yfzzzyyls/ECE9433-SoC-Design-Project/docs/course_ece9433_tutorial_dc_tsmc16.pdf

Tutorial | ECE 9433: System-On-Chip Design

# Tutorial: Design Compiler NXT

## 1 Introduction

This tutorial provides a step-by-step guide to using Synopsys Design compiler, one of the most widely used tools for logic synthesis in digital design. Synthesis is a crucial phase in digital design, transforming a high-level description of a circuit, typically written in HDL like Verilog, SystemVerilog or VHDL, into a gate-level netlist. A simple design is uploaded to brightspace, please download and import the design folder to fastX3.

Main steps in Synthesis Flow:

- Specify Libraries
- Read RTL
- Applying Timing Constraints
- Synthesize the Design
- Generate Reports
- Save the Results

## 2 Specify Libraries

1. Edit your ˜/tcshrc synopsys local file by changing the value of SYN HOME to:

/eda/synopsys/syn/W-2024.09-SP5-5

Then add the following line at the bottom of the file:

set path=($SYN˙HOME/bin $path)

2. Unzip the folder using the command: unzip lab1.zip. Change the directory to lab1. The setup.tcl file sources the rm setup/dc setup.tcl file which in turn sources the rm setup/common setup.tcl file.
3. Invoke the DC NXT in topographical mode using the command: dcnxt˙shell -topo -gui
4. Execute the command from the same terminal you launched the tool or you can run these command from the input area at the bottom of the GUI: source setup.tcl

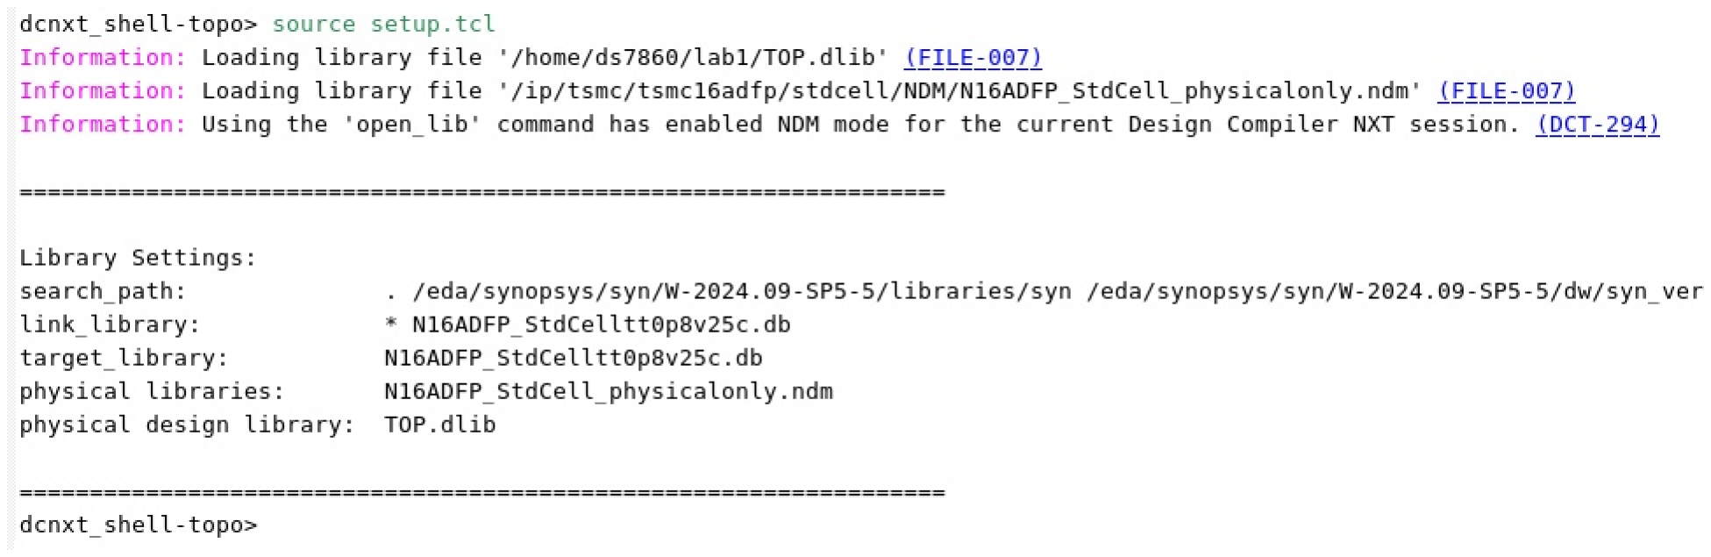
[picture p3: figure]

Fall 2025

## 3 Read RTL

1. Depending on the type of file, specify the format as shown below (enter only one of the following):
a. analyze -f verilog TOP.v
b. analyze -f vhdl TOP.vhd
2. After reading the rtl file, elaborate the design by specifying the TOP module name: elaborate TOP
3. Now you should be able to see the modules in the Logical Hierarchy pane at the upper-left of the GUI, there is a T icon called TOP, which is the top-level, and there are icons for the lower level hierarchical (H) instances as shown below:
4. Use the following commands to list the libraries and designs:
a. list˙libs
b. list˙designs

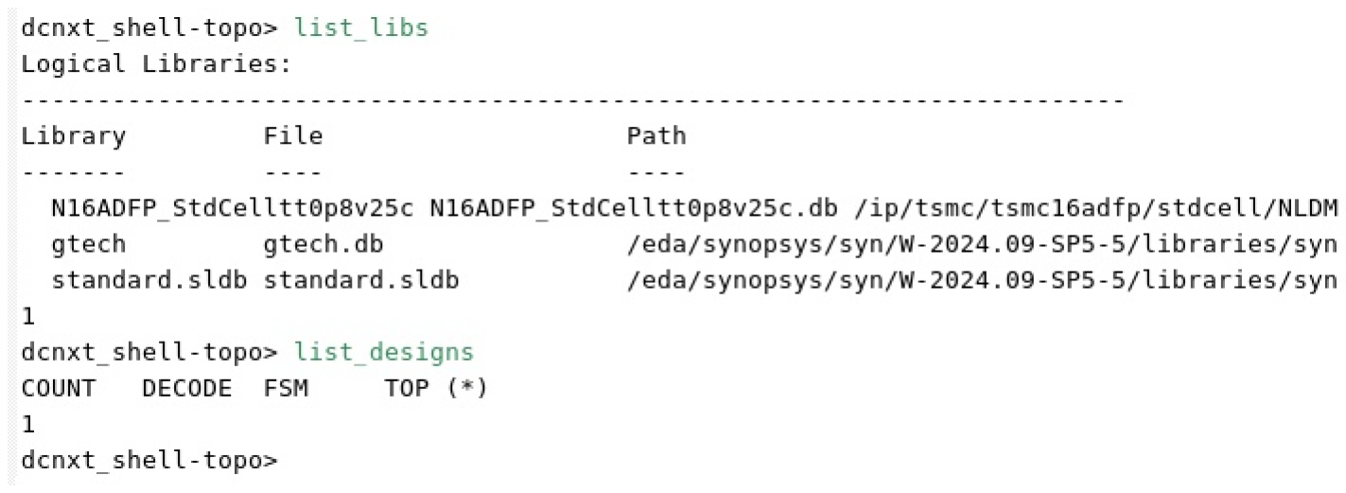
[picture p4: figure]

5. It is always a good practice to save the design as an unmapped ddc file at this step. Remember that we still haven’t applied any constraints to our design. If we have applied the constraints, then we will save it to the mapped folder. For now execute this command: write˙file -hier -f ddc -output ./unmapped/TOP.ddc

## 4 Apply Timing Constraints

1. Verify that the current design is TOP by executing the following command: current˙design
2. Source the constraints to the design by sourcing the SDC file: source TOP.con

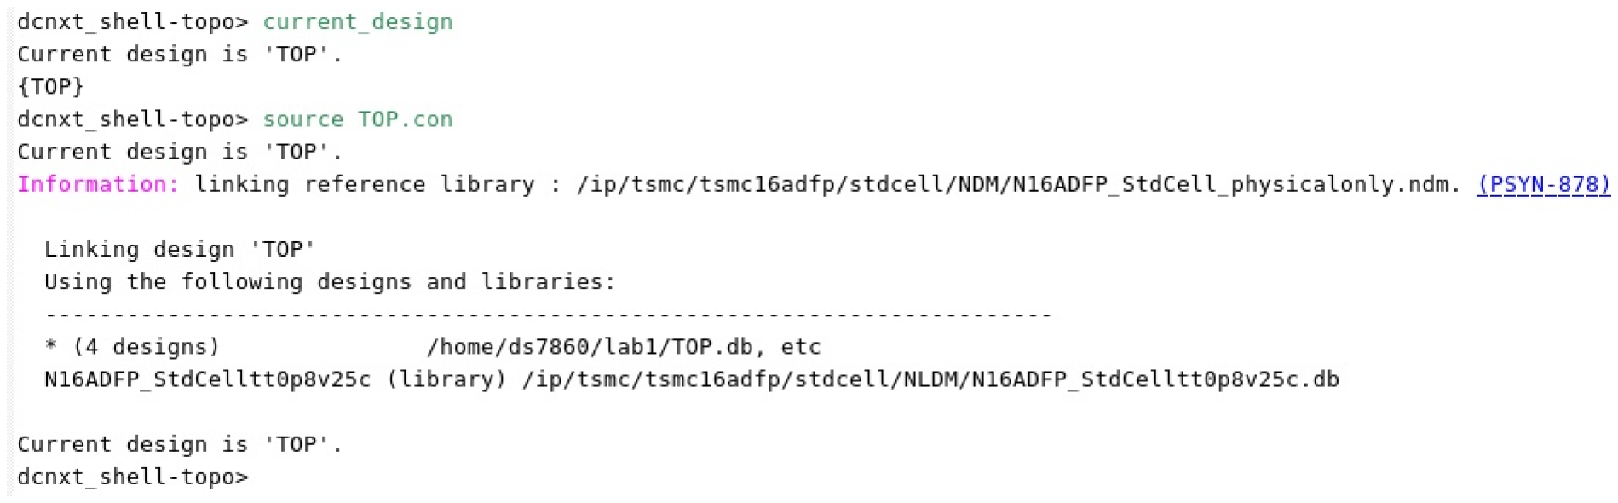
[picture p5: figure]

## 5 Synthesize the Design

1. Perform synthesis by entering the following command: compile˙ultra
2. Watch the log by increasing the size of the terminal from which you launched the dcnxt shell, you will see different warnings and errors. But you can also see Library analysis succeeded.

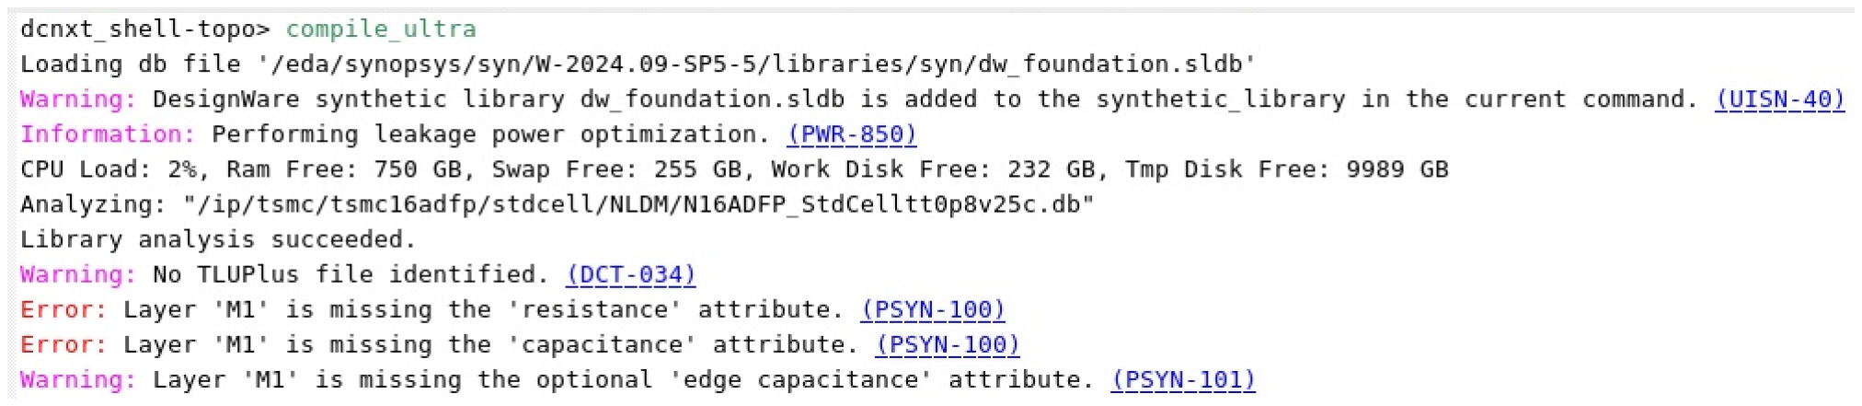
[picture p6: figure]

## 6 Generate Reports

1. Report all the violations by entering the following command: report˙constraints -all˙violators
2. Generate a more detailed timing report by entering the following command: report˙timing
3. Generate an area report: report˙area
4. You can update the clock period in TOP.con based on the timing violation and source the TOP.con file and run the synthesis again.
5. You can generate the power report using the command: report˙power

## 7 Save the Results

1. Select File - Save As - mapped
2. Specify the file name as TOP.ddc
3. Make sure Save all designs in the hierarchy button is checked, this will save the entire design hierarchy into a single file and click Open
4. Alternatively we can save the design by running the command (similar to unmapped file at beginning):

write -hierarchy -format ddc -output lab1/mapped/TOP˙netlist.ddc

5. If you want the output netlist in verilog format, run the following command:

write -format verilog -hierarchy -output TOP˙netlist.v

6. If you are using Synopsys IIC2 for physical design, you can save the output as ASCII format:

write˙icc2˙files -output ./mapped/TOP˙icc2

## References

- Design Compiler NXT Tutorial from ECE-GY 6443: VLSI System and Architecture Design SPRING 2025
