yfzzzyyls/ECE9433-SoC-Design-Project/(commit log)

2025-09-05 lab1 bug fix: should declare variable in the input, not inside the init block for testbench files
    [lfsr_tb_basic.sv, lfsr_tb_edge.sv, lfsr_tb_sequence.sv]
2025-09-14 adjust tb file interface: tb files should act like main device in the specification
2025-09-14 upload lab1 fixes that were not uploaded before
    [lfsr_tb_edge.sv, lfsr_tb_sequence.sv]
2025-09-15 fix problem with interface
    [spi_tb_basic.sv]
2025-09-15 bug fix: do not keep r_en high for 44 cycles
    [spi_sub.sv]
2025-09-16 a quite major fix: fix timing issue
    [spi_sub.sv, spi_tb_basic.sv]
2025-09-16 half cycle timing bug fix
    [spi_sub.sv, spi_tb_basic.sv]
2025-09-16 try to resolve false positive issue
    [spi_sub.sv, spi_tb_basic.sv]
2025-09-17 replace spi_sub.sv with spi_sub_golden.sv
    [spi_sub.sv, spi_tb_basic.sv]
2025-09-17 Add 5 passing SPI testbenches for mutation testing
2025-09-17 FINISH: this testbench will capture all 5 bugs and get full points on Autograder
    [spi_tb_all.sv]
2025-12-03 1. change naming of bus to avoid conflict with synopsis key words. 2. change the firmware memory size to match the TSMC16 pdk's SRAM macro size: 512x45
    [interconnect.sv, soc_top.sv, sram.sv]
2026-01-24 WIP: Power grid iterations V91-V102 for LVS fix
    Extensive work on fixing LVS violations caused by SRAM blocking M9 power grid:
    - V91-V95: M8 bridge stripes around SRAM region
    - V96: M4-M7 intermediate stripes (reduced LVS 705→109, but 337 DRC MINSTEP)
    - V97: M8 ring only (0 DRC, 707 LVS)
    - V98-V101: Various stripe widths (0.5-2.0um) to balance via generation vs MINSTEP
    - V102: Simplified addRing approach around SRAM block
    Key findings:
    - ViaGen fails due to SPANLENGTHTABLE/SPACING rules at M5-M7 layers
    - M9 stripes split at SRAM region (X=65-118) creates connectivity gap
    - PDK requires careful stripe width selection for legal via landing
    Current status: 0 DRC achievable, LVS still has ~7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
